DuncNam/pan-tilt-tracker/docs/SysReq_PanTiltTracker_v1_3.docx

SYSTEM REQUIREMENTS

Real-Time Pan-Tilt Laser Tracking System

Author | Duncan Nam
Version | 1.3
Date | 2026-AUG-06
Status | As-Built

# 1. System Overview

The system shall detect a user-defined colored object in real time using a USB webcam, compute the object's centroid position in the camera frame, and command a two-axis pan-tilt servo mount to center the object. A laser pointer mounted to the pan-tilt assembly shall track the object. The system is intended as a personal engineering demonstration project. [DESCOPED in v1.2: the live WiFi camera feed to a MacBook was removed; the system runs headless and is observed by the laser on the wall.]

# 2. Functional Requirements

- FR-01 Color Detection: System shall detect a user-specified HSV color range in the camera frame and identify the target object's centroid.
- FR-02 Servo Control: System shall command pan and tilt servo angles to maintain target centroid within a defined deadband of frame center.
- FR-03 PID Tracking: System shall implement a proportional-integral-derivative (PID) control loop to drive pan/tilt error to zero.
- FR-04 Serial Link: Raspberry Pi shall transmit pan/tilt angle commands to Arduino via USB serial.
- FR-05 Video Stream [DESCOPED v1.2]: System shall stream the annotated live camera feed (with centroid overlay) to a MacBook Air via local WiFi network browser. Removed in v1.2 — the system runs headless with no display or stream; tracking is verified by the laser on the wall. The annotation/overlay was unnecessary once the feed was dropped.
- FR-06 Laser Output: A 5mW 650nm laser module mounted to the servo assembly shall point at the tracked object.
- FR-07 Camera Mount: Camera shall be co-mounted on the pan-tilt servo assembly with the laser module and move as a single rigid unit.

# 3. Performance Requirements

- PR-01 Frame Rate: Vision processing pipeline shall operate at >= 30 fps.
- PR-02 Tracking Latency: End-to-end latency from object movement to servo response shall be <= 150 ms.
- PR-03 Angular Range: Pan axis: +/-90 degrees. Tilt axis: +/-45 degrees.
- PR-04 Deadband: Servo shall not be commanded if centroid error is < 20 pixels from frame center (prevents jitter).
- PR-05 Stream Latency [DESCOPED v1.2]: Video stream latency to MacBook browser shall be <= 500 ms. N/A in v1.2 — streaming removed.

# 4. Hardware Constraints

- HC-01 Compute: Raspberry Pi 5.
- HC-02 Microcontroller: Arduino Uno for servo PWM output.
- HC-03 Camera: Logitech Brio 101 USB webcam, connected to Raspberry Pi.
- HC-04 Servos: 2x MG996R Metal Gear servos on aluminum pan-tilt bracket. MG996R selected over MG90S after torque analysis — camera co-mount load (~200g) requires minimum 0.8kg/cm; MG996R provides 9kg/cm at 4.8V with adequate safety margin.
- HC-05 Laser: 5mW 650nm laser module, 3.3V or 5V compatible.
- HC-06 RPi-Arduino Link: USB serial (via termios.h).
- HC-07 Servo Power: Dedicated 5V 5A DC power supply for servo power domain. Servo power isolated from Arduino and RPi power domains. Common ground shared across all domains.

# 5. Software Constraints

- SC-01 Language: C++ on Raspberry Pi. C++ (Arduino framework) on Uno.
- SC-02 Vision Library: OpenCV C++ API.
- SC-03 OS: Raspberry Pi OS (64-bit, Debian-based Linux).
- SC-04 Streaming [DESCOPED v1.2]: mjpg-streamer running as a background process on RPi. Not used in v1.2 — streaming removed; the system runs headless.
- SC-05 Version Control: Git / GitHub with README and demo video for portfolio visibility.

# 6. Out of Scope

- Multi-object tracking.
- Autonomous target classification (color heuristic only, no ML).
- Wireless Arduino communication.
- Persistent data logging.

# 7. Acceptance Criteria

The system shall be considered complete when it can reliably track a handheld colored object across the angular range of the mount without losing lock within its characterized speed envelope. (v1.2: the original criterion also required the annotated feed to be visible in a MacBook browser; this was removed with the streaming descope.)

# 8. Future Improvements

The following capabilities are planned for future versions and are out of scope for v1.0:

- Variable lighting adaptation via adaptive HSV thresholding or histogram equalization.
- Multi-object tracking with target prioritization.
- Stereo vision range finding using a second Logitech Brio 101 at a fixed baseline.
- LiDAR module (e.g. TF-Luna) integration for precision ranging at extended distances.
- Feedforward / predictive tracking (target velocity estimate or Kalman filter) to cancel the steady-state following lag of the current reactive controller. (Note: the v1.0 future item "upgrade from proportional-only to full PID" is complete — a velocity-form PID with tuned integral and derivative terms is implemented.)

# 9. Revision History

Version | Date | Author | Changes
1.0 | 2026-MAY-02 | Duncan Nam | Initial release.
1.1 | 2026-MAY-09 | Duncan Nam | Updated servo selection to MG996R, added FR-07 camera mount requirement, added HC-07 servo power constraint, added Section 8 Future Improvements, added revision history.
1.2 | 2026-JUN-28 | Duncan Nam | Descoped WiFi video streaming (FR-05, PR-05, SC-04) and updated acceptance criteria accordingly; system runs headless. Corrected camera (HC-03) to Logitech Brio 101. Noted proportional-to-PID upgrade complete; velocity-form PID with tuned gains implemented. Status set to As-Built.
1.3 | 2026-AUG-06 | Duncan Nam | Updated deadband threshold due to centroid noise floor limitation (PR-04).

# Appendix A — System Architecture Diagram

Figure A-1. Hardware and software component interfaces.

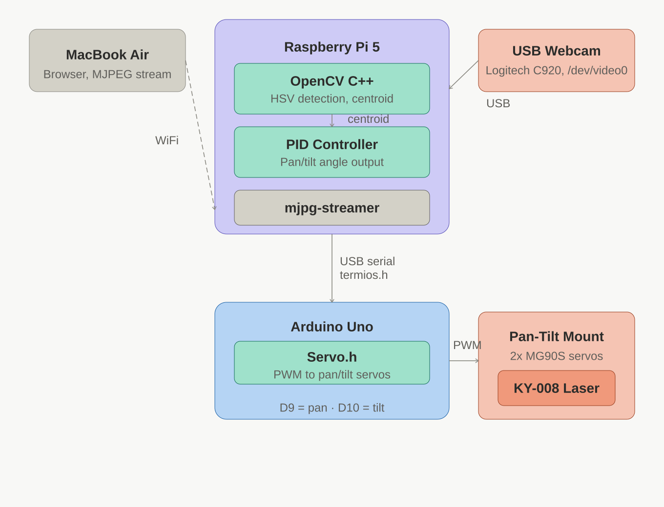
[picture p2: figure]

v1.1 — Duncan Nam — 2026-MAY-09
