DuncNam/pan-tilt-tracker/media/assembly_photos/RPi_laser.jpeg

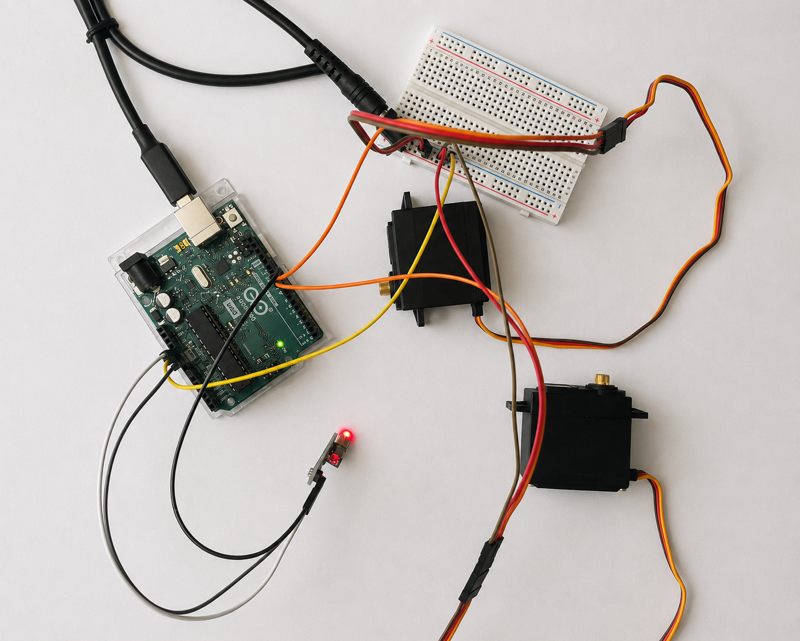
media/assembly_photos/RPi_laser.jpeg
