DuncNam/pan-tilt-tracker/media/assembly_photos/RPi_webcam.jpeg

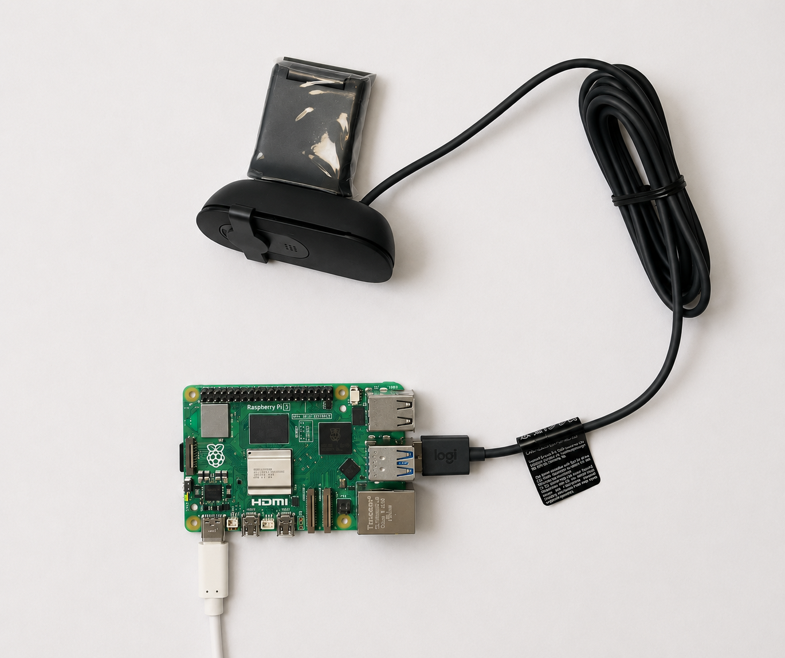
media/assembly_photos/RPi_webcam.jpeg
