DuncNam/pan-tilt-tracker/media/assembly_photos/servos.jpeg

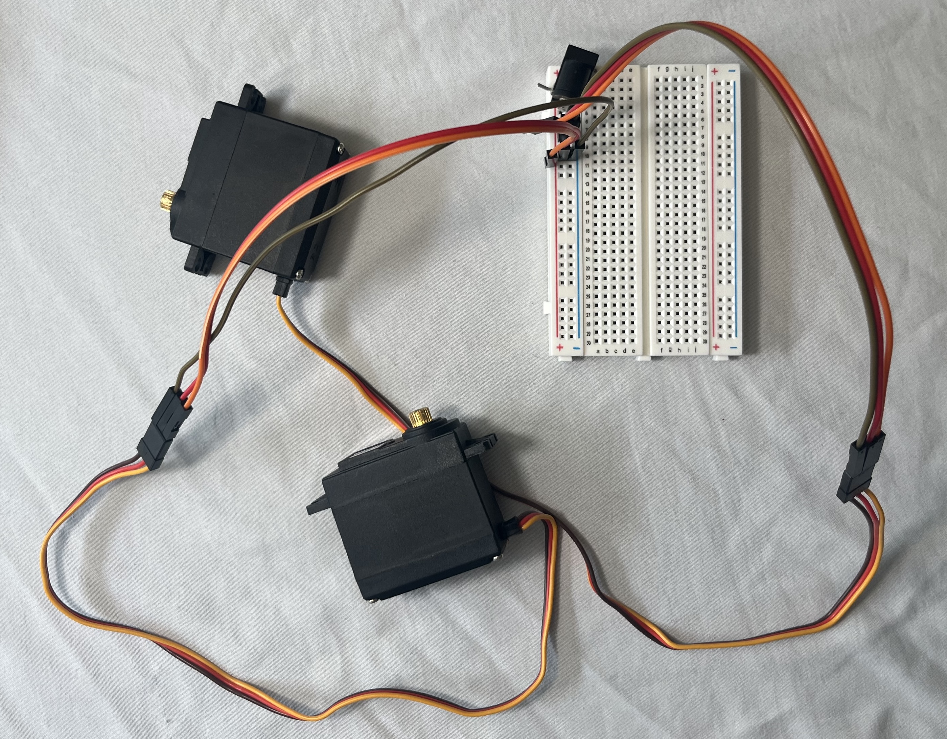
media/assembly_photos/servos.jpeg
