DuncNam/pan-tilt-tracker/media/assembly_photos/wired_assembly.jpeg

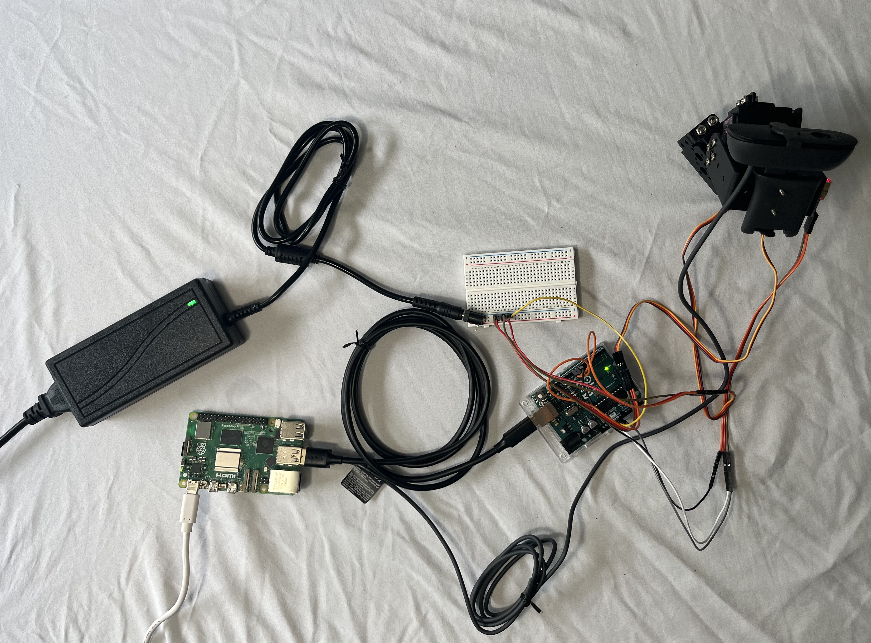
media/assembly_photos/wired_assembly.jpeg
