DuncNam/pan-tilt-tracker/calibration/data/sweep_coarse.csv

pass | dir | pulse_us | cx | cy | area | valid | deg
1 | 1 | 1250 | 85.6274 | 365.675 | 1699 | 1 | -22.7659
1 | 1 | 1260 | 106.905 | 365.738 | 1688.5 | 1 | -21.9768
1 | 1 | 1270 | 128.501 | 365.852 | 1657 | 1 | -21.1667
1 | 1 | 1280 | 142.403 | 365.901 | 1659 | 1 | -20.6405
1 | 1 | 1290 | 187.575 | 365.742 | 1609.5 | 1 | -18.9056
1 | 1 | 1300 | 199.877 | 365.809 | 1599 | 1 | -18.4267
1 | 1 | 1310 | 232.88 | 366.041 | 1556.5 | 1 | -17.1288
1 | 1 | 1320 | 253.746 | 365.814 | 1515 | 1 | -16.2986
1 | 1 | 1330 | 274.993 | 365.677 | 1521.5 | 1 | -15.4461
1 | 1 | 1340 | 298.259 | 365.728 | 1491.5 | 1 | -14.5044
1 | 1 | 1350 | 323.176 | 365.992 | 1460.5 | 1 | -13.4869
1 | 1 | 1360 | 337.688 | 366.126 | 1446 | 1 | -12.8902
1 | 1 | 1370 | 361.67 | 366.128 | 1428.5 | 1 | -11.898
1 | 1 | 1380 | 398.058 | 365.855 | 1407.5 | 1 | -10.3787
1 | 1 | 1390 | 411.776 | 365.831 | 1393.5 | 1 | -9.802
1 | 1 | 1400 | 434.739 | 365.982 | 1376.5 | 1 | -8.83218
1 | 1 | 1410 | 462.979 | 365.725 | 1368.5 | 1 | -7.63247
1 | 1 | 1420 | 485.456 | 365.743 | 1357 | 1 | -6.6727
1 | 1 | 1430 | 498.596 | 365.808 | 1351.5 | 1 | -6.10988
1 | 1 | 1440 | 531.709 | 365.563 | 1339.5 | 1 | -4.68641
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
