DuncNam/pan-tilt-tracker/calibration/data/sweep_fine.csv

pass | dir | pulse_us | cx | cy | area | valid | deg
1 | 1 | 1475 | 611.923 | 359.609 | 1294.5 | 1 | -1.21759
1 | 1 | 1476 | 612.181 | 359.711 | 1306.5 | 1 | -1.20642
1 | 1 | 1477 | 610.831 | 359.645 | 1299 | 1 | -1.26495
1 | 1 | 1478 | 610.34 | 359.711 | 1304 | 1 | -1.28621
1 | 1 | 1479 | 611.617 | 359.614 | 1300 | 1 | -1.23088
1 | 1 | 1480 | 627.499 | 359.576 | 1302.5 | 1 | -0.542205
1 | 1 | 1481 | 625.907 | 359.565 | 1307 | 1 | -0.611238
1 | 1 | 1482 | 640.031 | 359.467 | 1303.5 | 1 | 0.00134916
1 | 1 | 1483 | 641.543 | 359.436 | 1288.5 | 1 | 0.0669422
1 | 1 | 1484 | 642.397 | 359.443 | 1296.5 | 1 | 0.10395
1 | 1 | 1485 | 640.926 | 359.534 | 1301.5 | 1 | 0.040146
1 | 1 | 1486 | 640.155 | 359.496 | 1298.5 | 1 | 0.00672855
1 | 1 | 1487 | 641.694 | 359.335 | 1289.5 | 1 | 0.073474
1 | 1 | 1488 | 651.116 | 359.37 | 1278 | 1 | 0.482132
1 | 1 | 1489 | 649.982 | 359.441 | 1282 | 1 | 0.432945
1 | 1 | 1490 | 649.468 | 359.338 | 1295 | 1 | 0.410632
1 | 1 | 1491 | 650.664 | 359.336 | 1282 | 1 | 0.46253
1 | 1 | 1492 | 651.338 | 359.386 | 1281 | 1 | 0.491752
1 | 1 | 1493 | 650.016 | 359.315 | 1290.5 | 1 | 0.434426
1 | 1 | 1494 | 650.141 | 359.168 | 1287.5 | 1 | 0.439827
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
