DuncNam/pan-tilt-tracker/(commit log)

2026-05-10 Add Arduino servo control sketch with serial communication
2026-05-10 Fix Arduino sketch folder structure
    [servo_control.ino]
2026-05-10 Add serial port communication and incremental servo control
2026-05-10 Update to v1.1: servo upgrade, FR-07, HC-07, future improvements, revision history
2026-05-24 Update serial port connection for RPi-Arduino connection
2026-05-24 Corrected typo in serial port connection for RPi-Arduino connection
    [tracker.cpp]
2026-05-24 Corrected postive/negative adjustment mistake in servo update
    [tracker.cpp]
2026-05-25 Adjusted servo update logic aagain
2026-05-30 Edit servo logic
2026-06-14 Added Arduino serial throttle
2026-06-15 Reduced frame rate and added serial flush
2026-06-18 Added serial drain to fix servo freezing
    [servo_control.ino]
2026-06-20 Added frame rate output
2026-06-22 Updated blob rejection logic to fix frame exit/re-enter issie
    [tracker.cpp]
2026-06-22 Inverted sign of math in previous push
    [tracker.cpp]
2026-06-22 Incremental update and signs flipped back lol
    [tracker.cpp]
2026-06-23 Updated to send non-integer servo commands
2026-06-23 Now that tracking is smoother, need to correct boresight adjustment
    [tracker.cpp]
2026-06-23 Adjusted gain to fix overcompensation
    [tracker.cpp]
2026-06-24 Boresight calibration
2026-06-24 Boresight calibration again
2026-06-24 Boresight calibration 3
2026-06-24 Pursuing velocity form PID by adding proportional term with gain at 0 for now
2026-06-24 Proportional gain calibration
2026-06-27 Added Derivative to PID logic
2026-06-28 Added debugging line to console print
2026-06-28 Fixed error in previous commit
    [tracker.cpp]
2026-06-28 Fixed the same error for real this time
    [tracker.cpp]
2026-06-28 Arduino: switch servo control from degrees to microseconds (and 115200 baud)
2026-06-28 Rewrite README, add demo media and calibration notes
2026-06-28 Sys Req and Assembly updates
2026-08-09 Locked camera exposure to reduce motion blur. Tuned deadband and boresight. SSH into RPi so no need to push/pull all code changes through GitHub
2026-08-09 Fixed mask issue with laser settled on target
    [tracker.cpp]
2026-08-09 Add calibration tooling and measured servo characterisation
    Measured values, replacing assumptions:
    - f_px = 1321, confirming the published 58 deg dFOV spec (wall calibration)
    - Pan servo 0.0971 deg/us over 1250-1750 us. Code assumed 0.090, a hidden
    7.9% loop gain error. Not validated outside the swept range.
    - Gear backlash 0.99 deg (11.5 us). Largest term in the pointing error
    budget, and larger than the servo's own 5 us deadband.
    - Servo internal deadband 5 us ascending / 4 us descending, matching the
    MG996R datasheet.
    - Optical axis is level at tilt 120 deg (1833 us), not the 90 deg assumed
    in code. Tilt sign is inverted relative to pulse width.
    Also fixes the laser-mask couplin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
    [sweep_coarse.csv, sweep_fine.csv]
